satyajeetdeshmukh/Standalone-PV-Simulation/PCB_DESIGN/pcb_mega_pins.jpeg

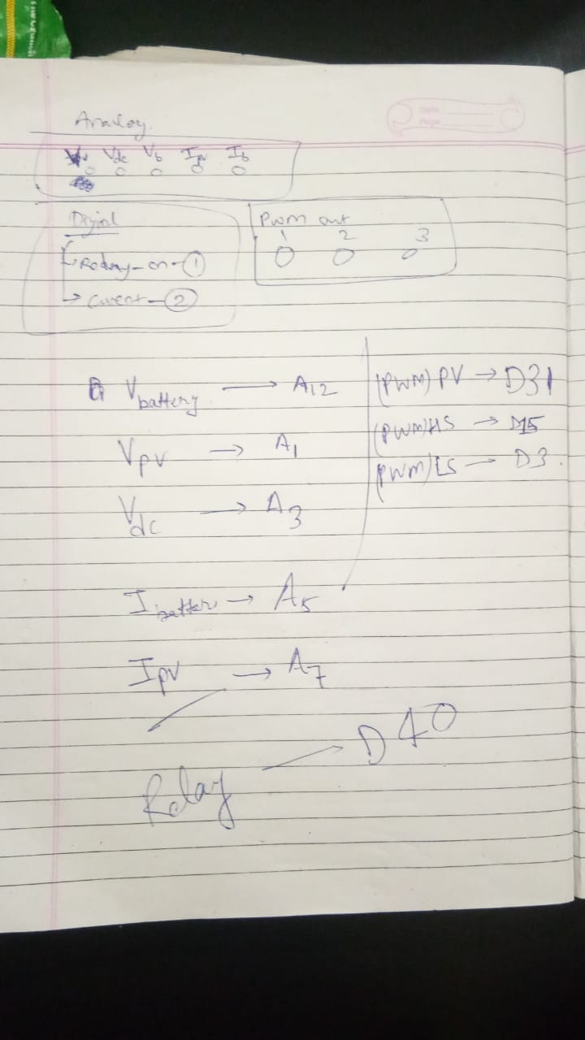
PCB_DESIGN/pcb_mega_pins.jpeg
