satyajeetdeshmukh/Standalone-PV-Simulation/Set up photos/IMG_20210410_151356.jpg

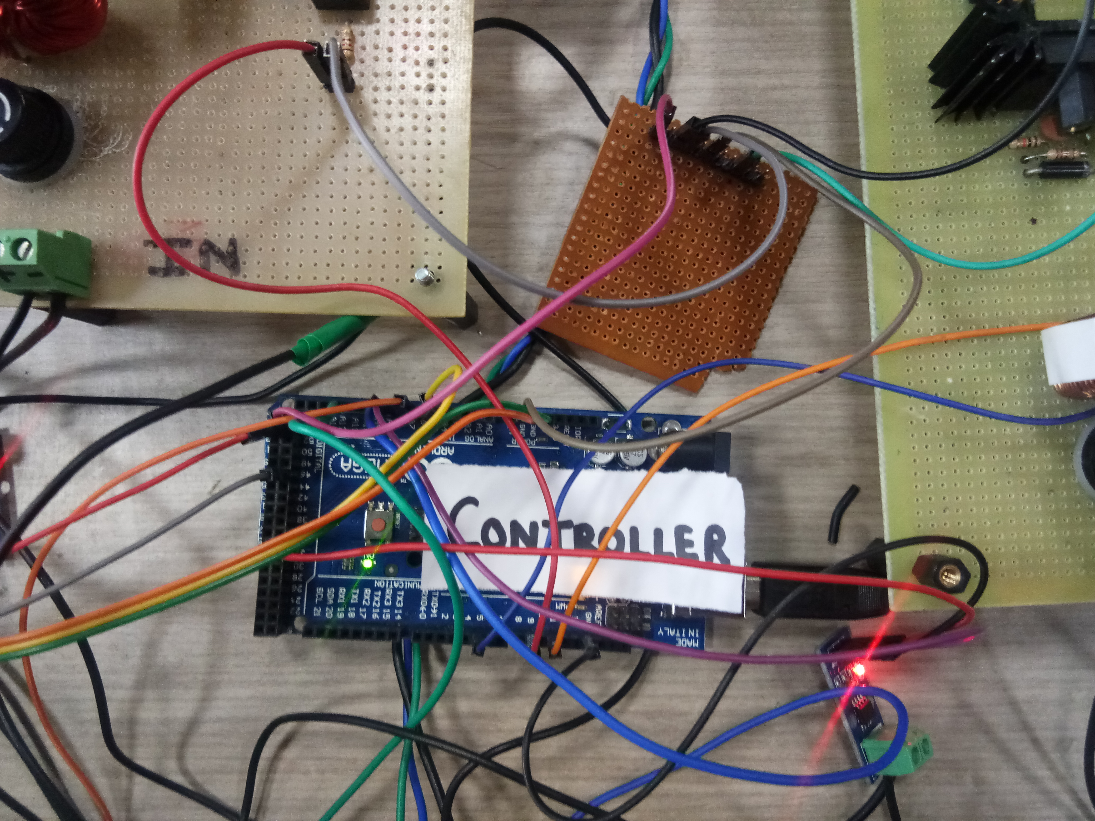
Set up photos/IMG_20210410_151356.jpg
