satyajeetdeshmukh/Standalone-PV-Simulation/Drawings/fig1 Schematic Block Diagram.pdf

PV
Subsystem

DC/DC Boost
Converter

DC/DC
Bidirectional
Converter

Load

DC - LINK

Battery
