satyajeetdeshmukh/Standalone-PV-Simulation/Drawings/fig3 Controller Design.pdf

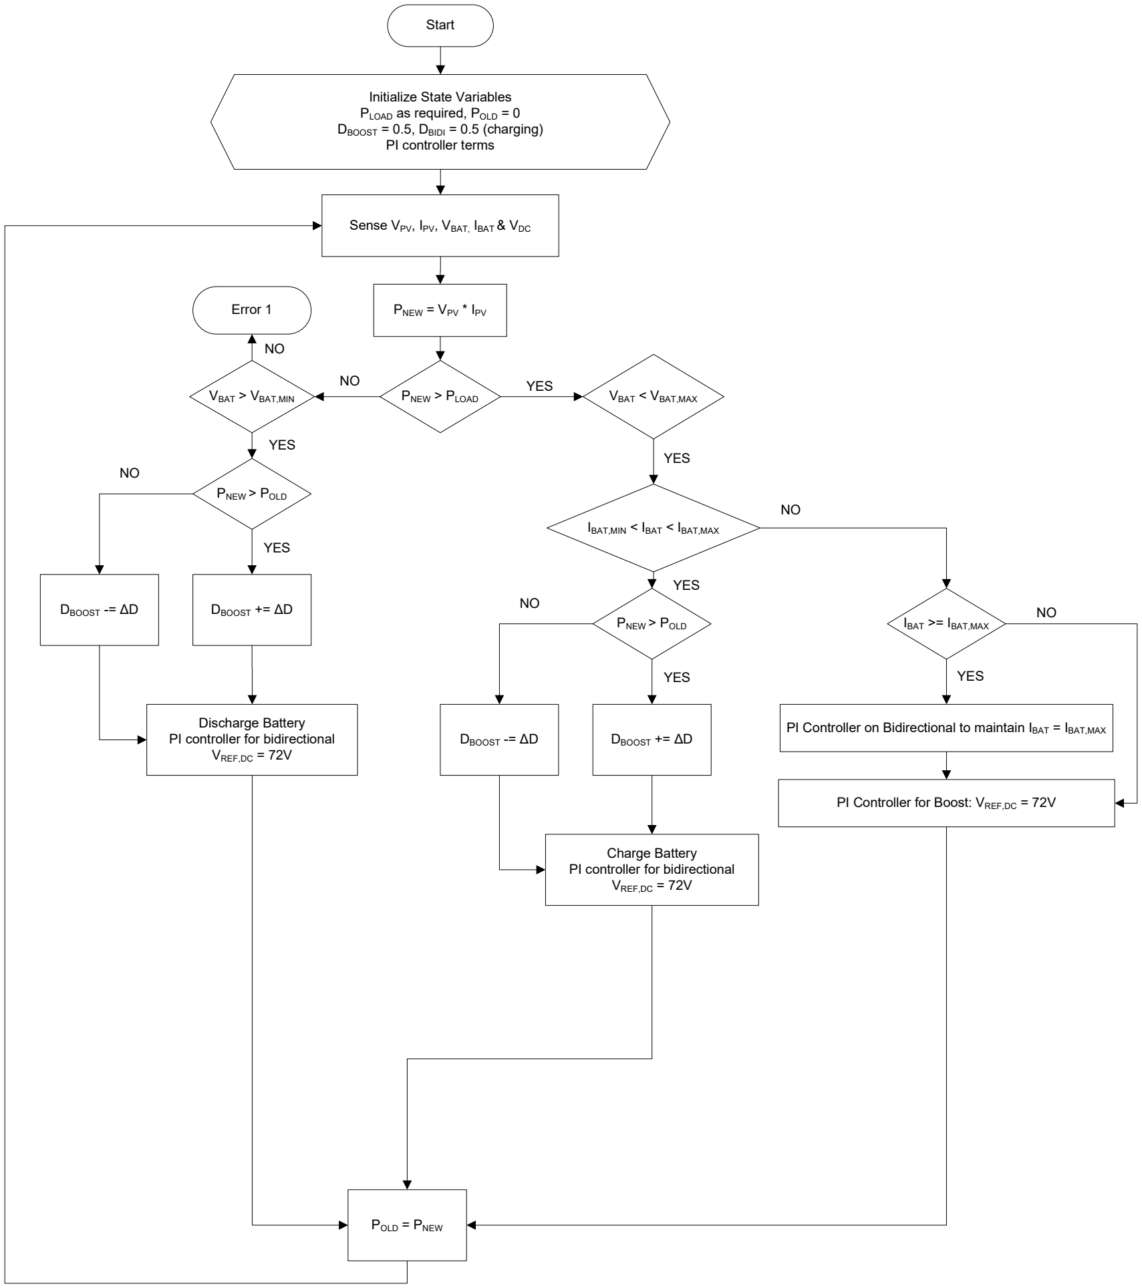
[picture p3: figure]
Sense VPV, IPV, VBAT, IBAT & VDC; Start; PNEW = VPV * IPV; VBAT > VBAT,MIN; PNEW > PLOAD; YES; PNEW > POLD; DBOOST -= ΔD; DBOOST += ΔD; Discharge Battery PI controller for bidirectional; VREF,DC = 72V; POLD = PNEW; VBAT < VBAT,MAX; IBAT,MIN < IBAT < IBAT,MAX; Charge Battery PI controller for bidirectional; Error 1; Initialize State Variables PLOAD as required, POLD = 0 DBOOST = 0.5, DBIDI = 0.5 (charging) PI controller terms; IBAT >= IBAT,MAX; PI Controller for Boost: VREF,DC = 72V

PI Controller on Bidirectional to maintain IBAT = IBAT,MAX
