satyajeetdeshmukh/Standalone-PV-Simulation/Drawings/fig 4 simple.pdf

PV
Subsystem | P.E. Converter | Load

Battery
