satyajeetdeshmukh/Standalone-PV-Simulation/Drawings/fig2 Basic Circuit Diagram.pdf

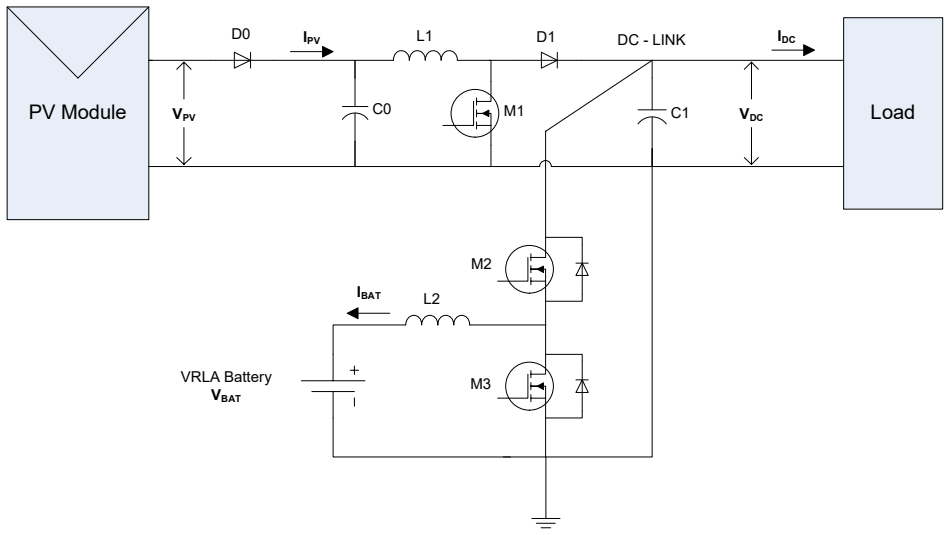
[picture p4: figure]
PV Module; Load; DC - LINK; VRLA Battery; VBAT; VDC; IBAT; IPV; IDC; VPV
