satyajeetdeshmukh/Standalone-PV-Simulation/Drawings/Control Logic - Modified.pdf

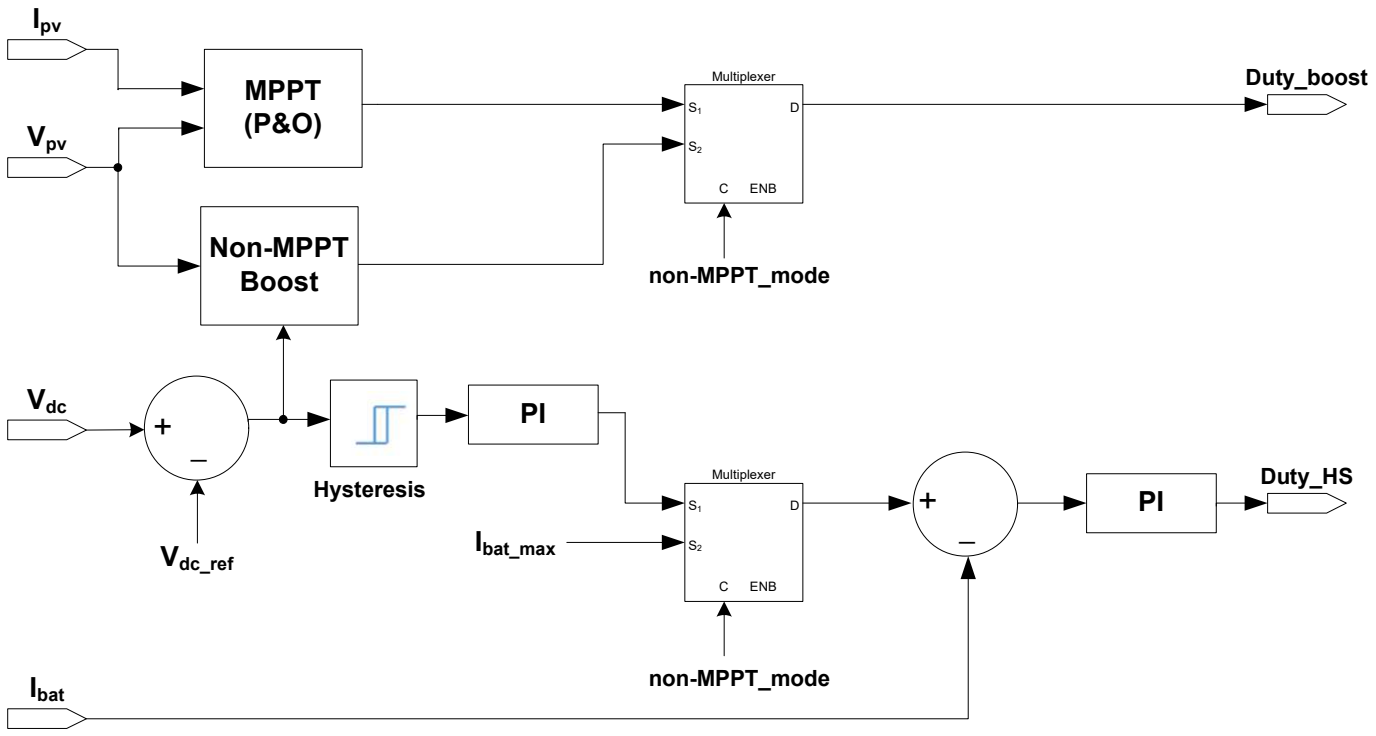
[picture p5: figure]
Ipv; Vpv; MPPT (P&O); Vdc; Vdc_ref; C ENB; Multiplexer; non-MPPT_mode; Duty_boost; Ibat_max; Ibat; Duty_HS; Hysteresis; Non-MPPT Boost
