satyajeetdeshmukh/Standalone-PV-Simulation/Drawings/DutyLS.pdf

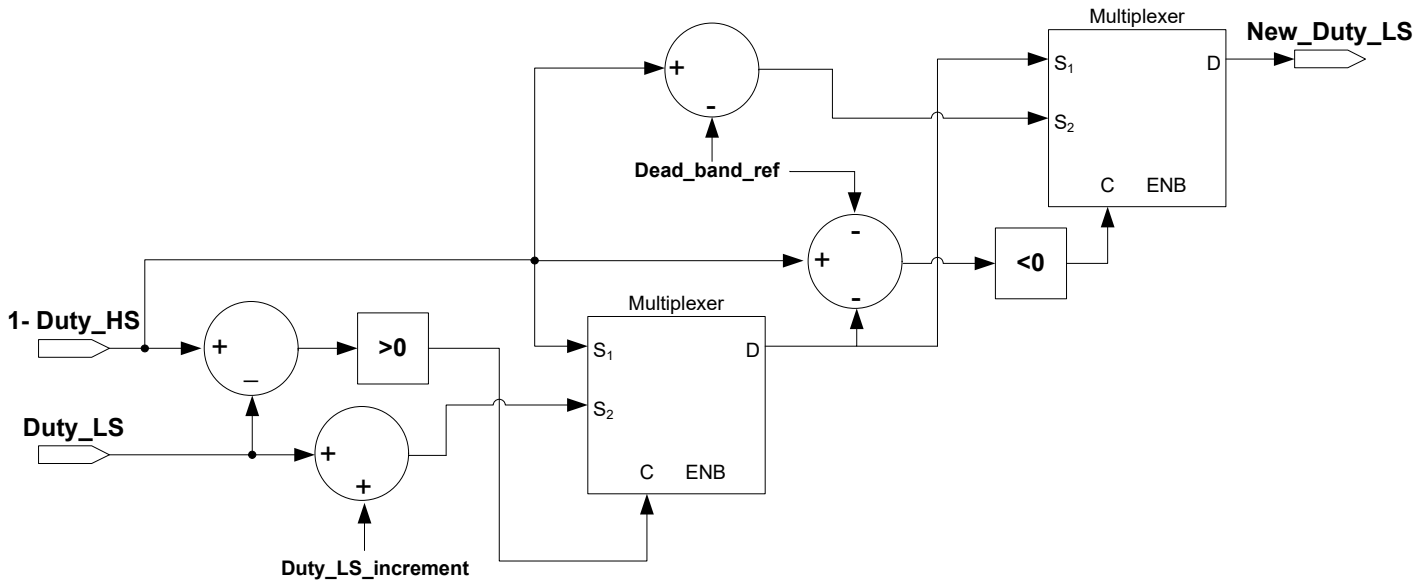
[picture p6: figure]
1- Duty_HS; Duty_LS; Duty_LS_increment; C ENB; Multiplexer; Dead_band_ref; New_Duty_LS
