satyajeetdeshmukh/Standalone-PV-Simulation/Drawings/basic_arduino_code.jpg

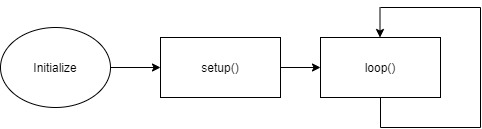
Drawings/basic_arduino_code.jpg
