satyajeetdeshmukh/Standalone-PV-Simulation/Drawings/loop_soft_start_mode.jpg

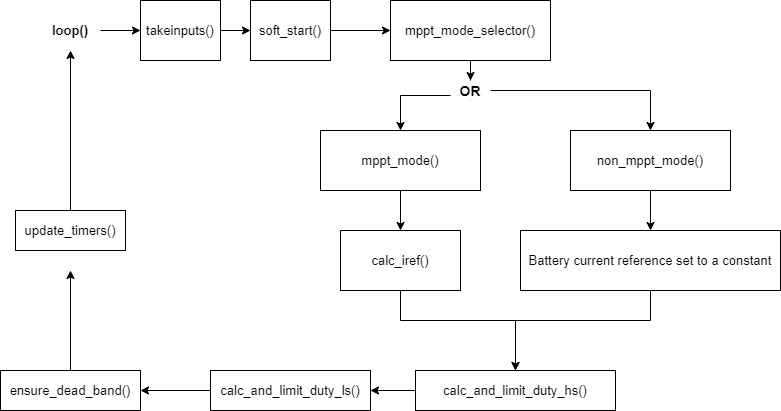
Drawings/loop_soft_start_mode.jpg
