satyajeetdeshmukh/Standalone-PV-Simulation/Set up photos/IMG_20210410_145839.jpg

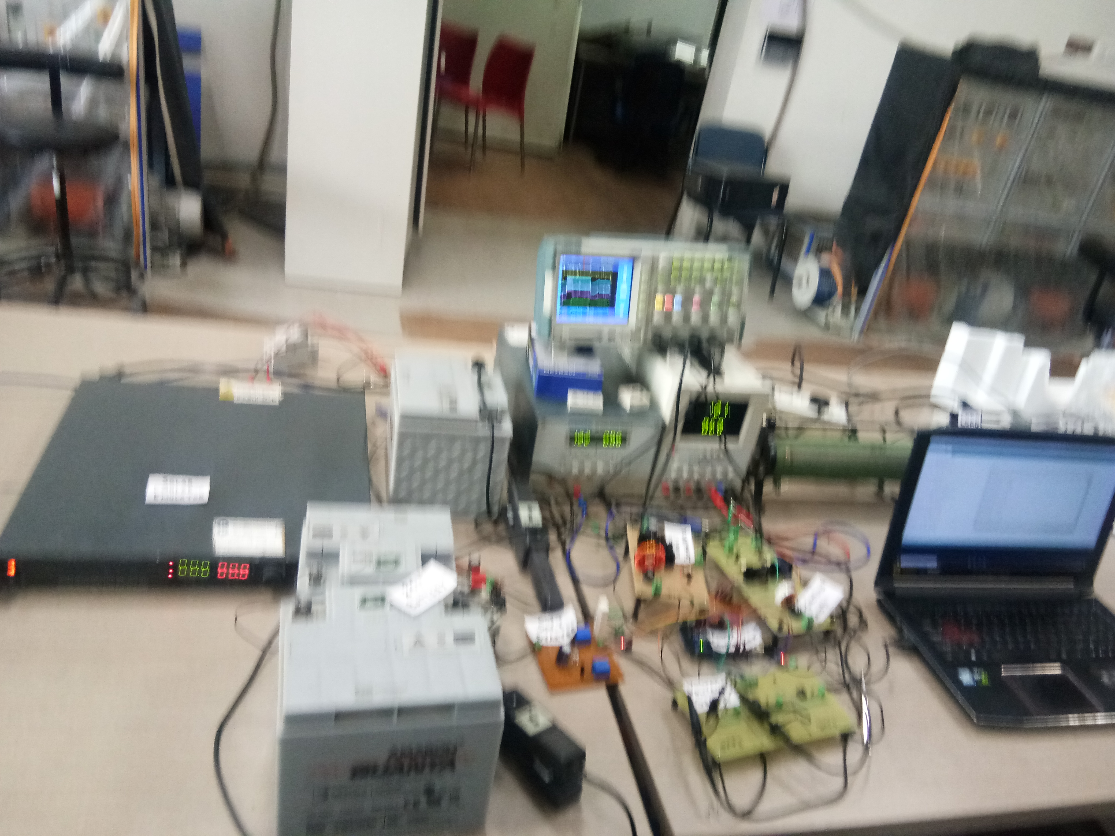
Set up photos/IMG_20210410_145839.jpg
