satyajeetdeshmukh/Standalone-PV-Simulation/Set up photos/IMG_20210410_151315.jpg

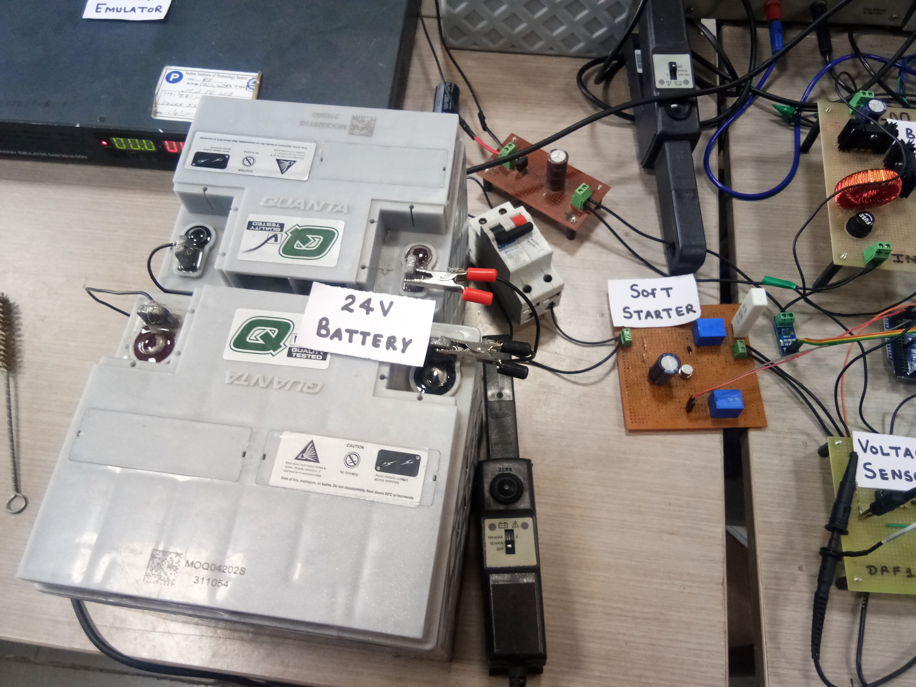
Set up photos/IMG_20210410_151315.jpg
