satyajeetdeshmukh/Standalone-PV-Simulation/Set up photos/IMG_20210411_142734.jpg

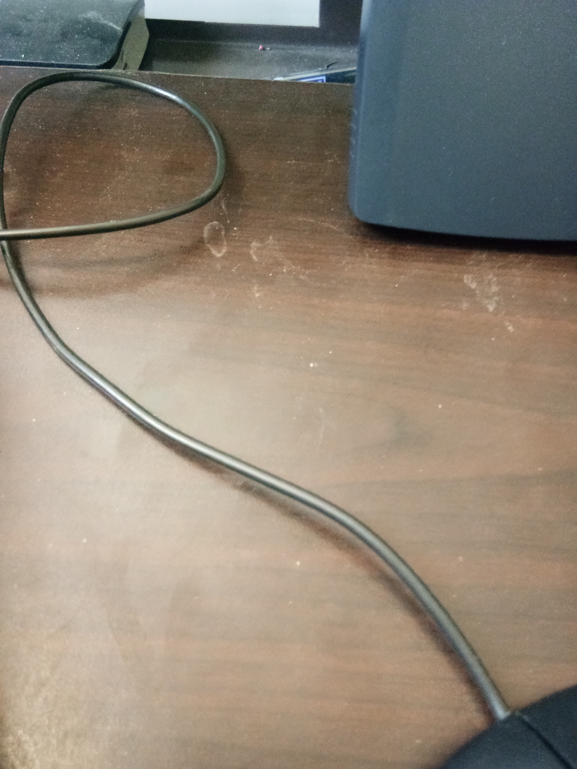
Set up photos/IMG_20210411_142734.jpg
