satyajeetdeshmukh/Standalone-PV-Simulation/Set up photos/IMG_20210412_125333.jpg

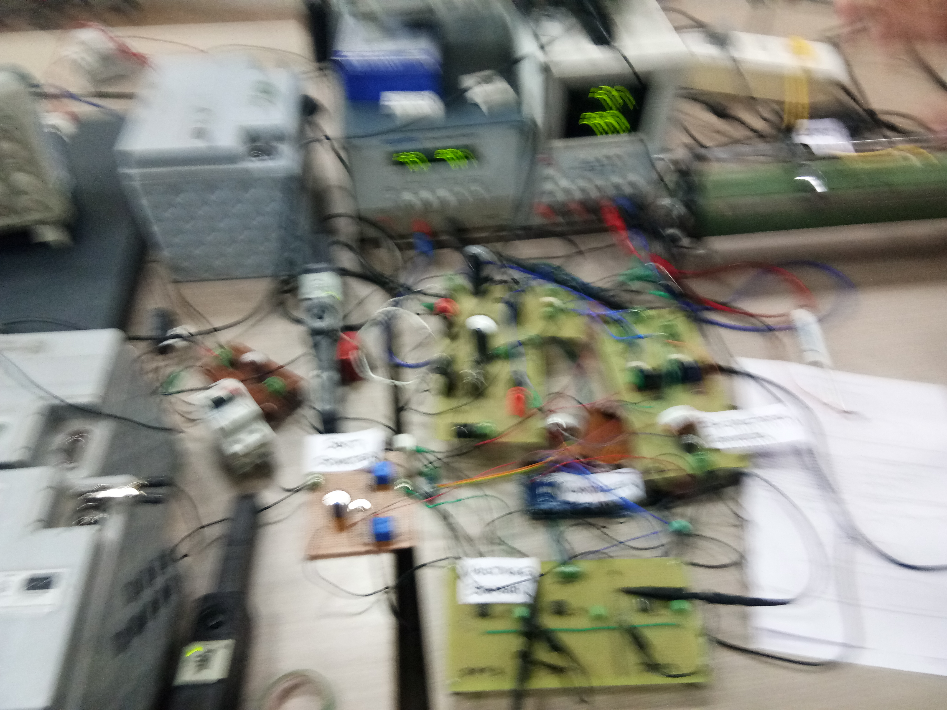
Set up photos/IMG_20210412_125333.jpg
