satyajeetdeshmukh/Standalone-PV-Simulation/Set up photos/IMG_20210412_125350.jpg

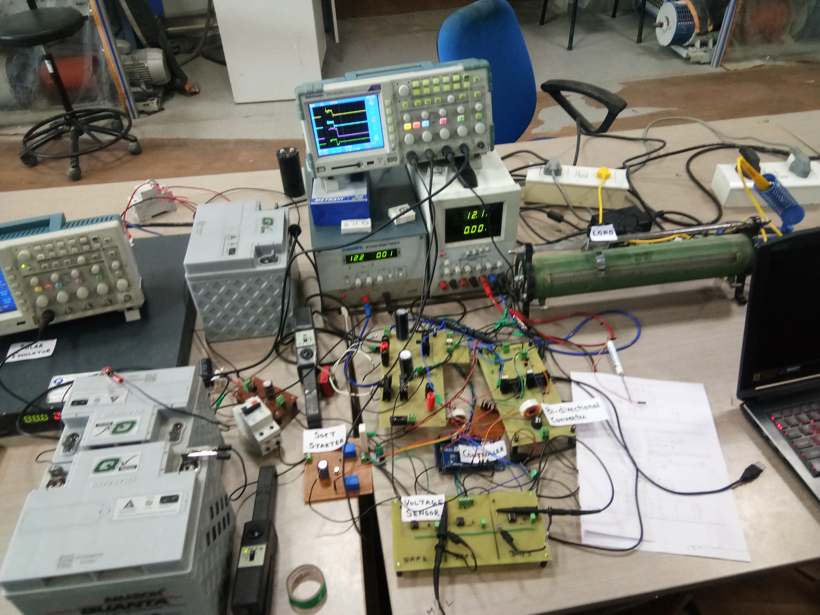
Set up photos/IMG_20210412_125350.jpg
