satyajeetdeshmukh/Standalone-PV-Simulation/Experimental_Results/Battery-only-mode/edited/full.jpg

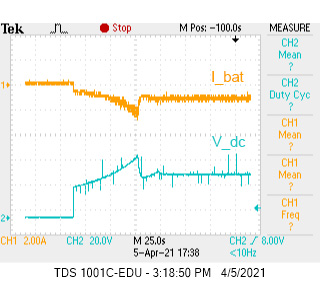
Experimental_Results/Battery-only-mode/edited/full.jpg
