satyajeetdeshmukh/Standalone-PV-Simulation/Experimental_Results/Battery-only-mode/edited/inductor current ripple stable.jpg

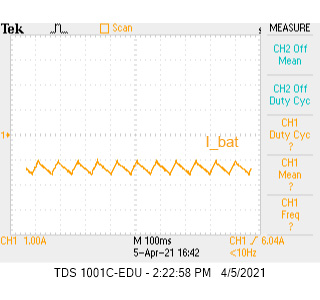
Experimental_Results/Battery-only-mode/edited/inductor current ripple stable.jpg
