satyajeetdeshmukh/Standalone-PV-Simulation/Experimental_Results/Battery-only-mode/edited/soft start.jpg

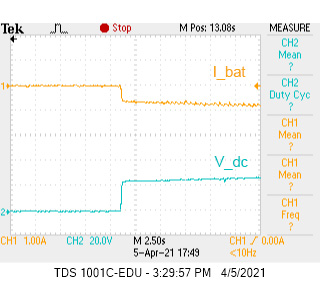
Experimental_Results/Battery-only-mode/edited/soft start.jpg
