satyajeetdeshmukh/Standalone-PV-Simulation/Experimental_Results/Battery-only-mode/steady state ch1-ib ch2-vo.bmp

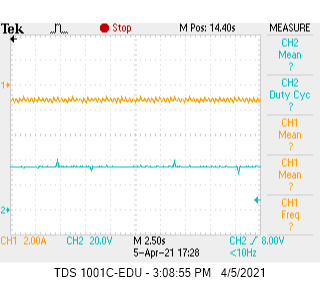
Experimental_Results/Battery-only-mode/steady state ch1-ib ch2-vo.bmp
