satyajeetdeshmukh/Standalone-PV-Simulation/Experimental_Results/battery-with-mppt/BO to BO+MPP to BO.bmp

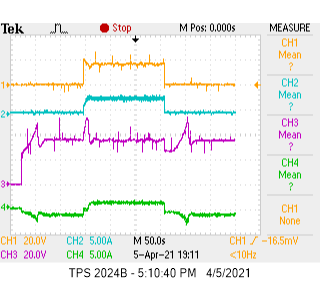
Experimental_Results/battery-with-mppt/BO to BO+MPP to BO.bmp
