satyajeetdeshmukh/Standalone-PV-Simulation/Experimental_Results/battery-with-mppt/edit/BO to BO+MPP to BO.jpg

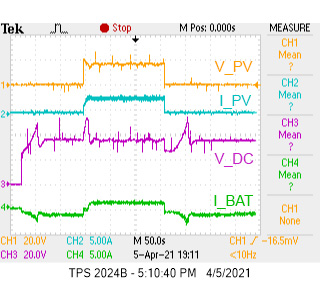
Experimental_Results/battery-with-mppt/edit/BO to BO+MPP to BO.jpg
