satyajeetdeshmukh/Standalone-PV-Simulation/Experimental_Results/battery-with-mppt/edit/mppt-with-battery-charging-to-discharging.jpg

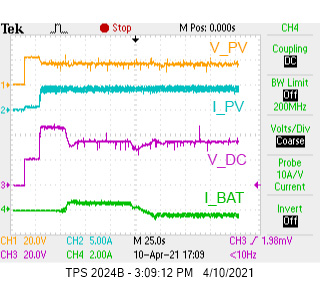
Experimental_Results/battery-with-mppt/edit/mppt-with-battery-charging-to-discharging.jpg
