satyajeetdeshmukh/Standalone-PV-Simulation/Experimental_Results/battery-with-mppt/full1.bmp

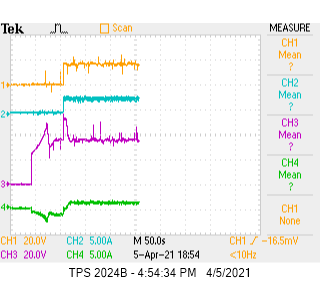
Experimental_Results/battery-with-mppt/full1.bmp
