satyajeetdeshmukh/Standalone-PV-Simulation/Experimental_Results/battery-with-mppt/mppt+battery to battery_only.bmp

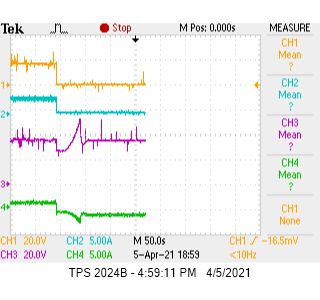
Experimental_Results/battery-with-mppt/mppt+battery to battery_only.bmp
