satyajeetdeshmukh/Standalone-PV-Simulation/Experimental_Results/battery-with-mppt/mppt_with_battery_charging-to-discharging/mppt-with-battery-charging-to-discharging.bmp

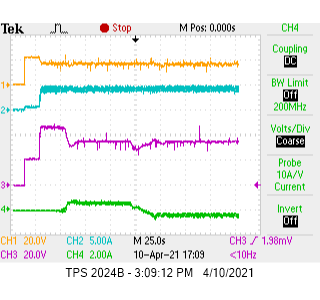
Experimental_Results/battery-with-mppt/mppt_with_battery_charging-to-discharging/mppt-with-battery-charging-to-discharging.bmp
