satyajeetdeshmukh/Standalone-PV-Simulation/Experimental_Results/mppt-to-non_mppt/2.bmp

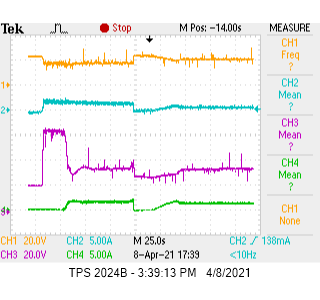
Experimental_Results/mppt-to-non_mppt/2.bmp
