satyajeetdeshmukh/Standalone-PV-Simulation/Experimental_Results/mppt-to-non_mppt/edit/mppt-to-non_mppt-to-mppt-2.jpg

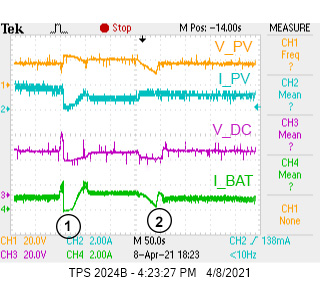
Experimental_Results/mppt-to-non_mppt/edit/mppt-to-non_mppt-to-mppt-2.jpg
