satyajeetdeshmukh/Standalone-PV-Simulation/Experimental_Results/mppt-to-non_mppt/mppt-to-non_mppt-to-mppt-2.bmp

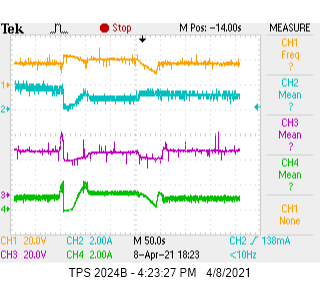
Experimental_Results/mppt-to-non_mppt/mppt-to-non_mppt-to-mppt-2.bmp
