satyajeetdeshmukh/Standalone-PV-Simulation/Experimental_Results/mppt-to-non_mppt/mppt-to-non_mppt-to-mppt.bmp

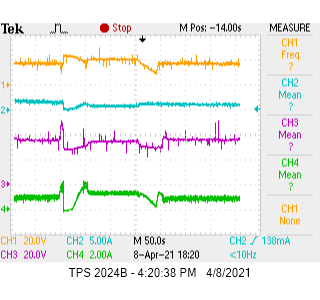
Experimental_Results/mppt-to-non_mppt/mppt-to-non_mppt-to-mppt.bmp
