satyajeetdeshmukh/Standalone-PV-Simulation/Experimental_Results/mppt-to-non_mppt/mppy_mode-to-non_mppt.bmp

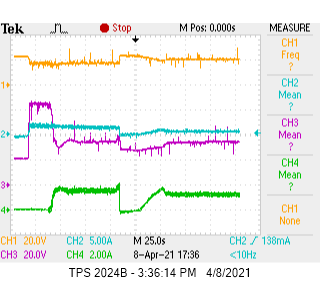
Experimental_Results/mppt-to-non_mppt/mppy_mode-to-non_mppt.bmp
