satyajeetdeshmukh/Standalone-PV-Simulation/Drawings/mode_selector.pdf

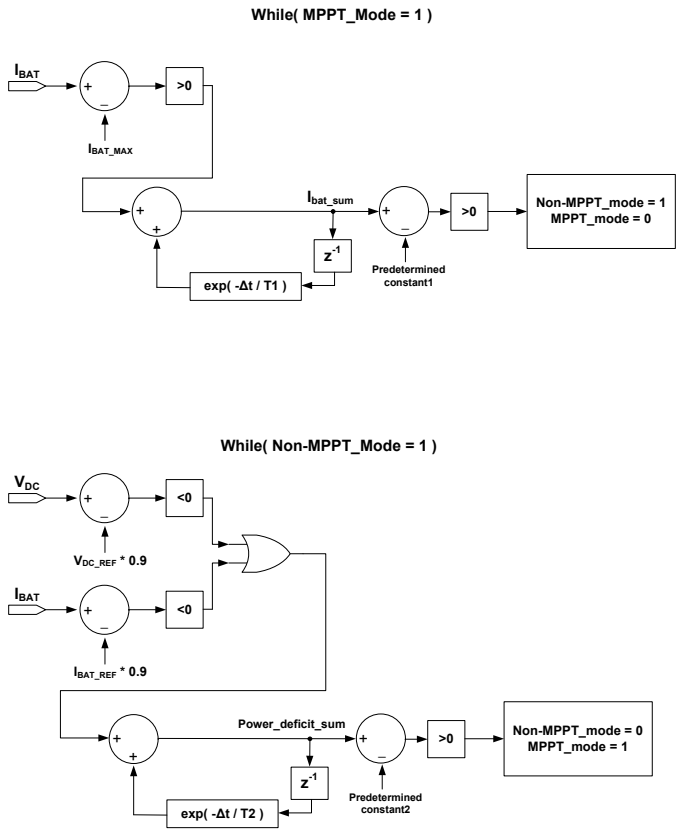
[picture p43: page 1]
Predetermined constant1; exp( -Δt / Τ1 ); Ibat_sum; Non-MPPT_mode = 1; MPPT_mode = 0; VDC; Predetermined constant2; Power_deficit_sum; Non-MPPT_mode = 0; MPPT_mode = 1; VDC_REF * 0.9; IBAT; IBAT_REF * 0.9; While( MPPT_Mode = 1 ); While( Non-MPPT_Mode = 1 ); exp( -Δt / Τ2 ); IBAT_MAX
