satyajeetdeshmukh/Standalone-PV-Simulation/PCB_DESIGN/FINAL2.PDF

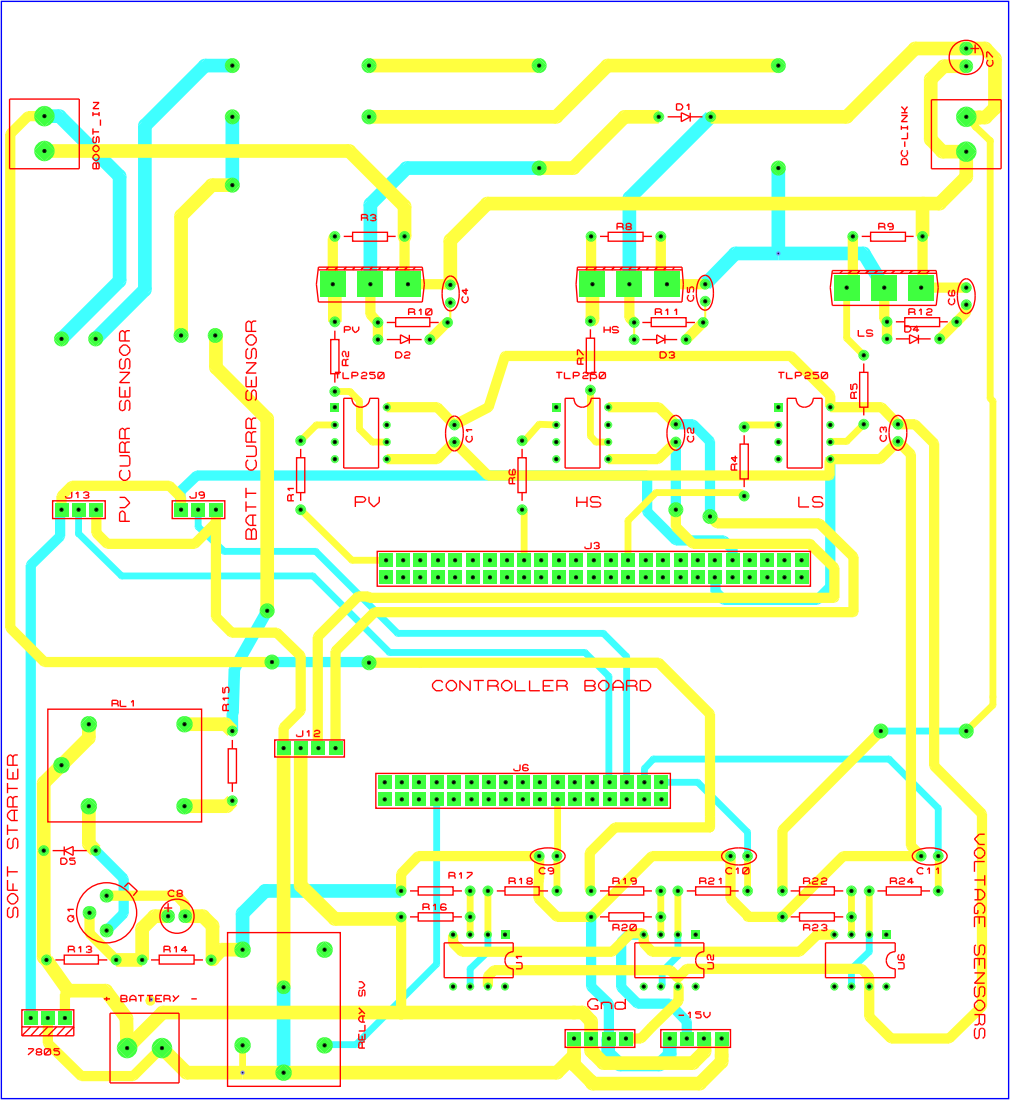
[picture p44: page 1]
