satyajeetdeshmukh/Standalone-PV-Simulation/(list of files, drawings)

Other design files:
PCB_DESIGN/FINAL2.pdsprj
PCB_DESIGN/FINAL.pdsprj
PCB_DESIGN/pcb_complete.pdsprj
PCB_DESIGN/Proteus/New Project.pdsprj
