satyajeetdeshmukh/Standalone-PV-Simulation/(commit log)

2021-02-18 more datasheets
    [BOM.xlsx]
2021-02-18 Create mosfet design considerations.pdf
2021-02-18 mosfet datasheet
2021-02-19 Design procedure for buck and boost
2021-02-20 added pdf, added proteus
    [New Project.pdsprj]
2021-03-17 bidi buck with resistor
2021-04-20 pcb and experimental setup images
    [FINAL.pdsprj, FINAL2.pdsprj, pcb_complete.pdsprj]
2021-04-20 arduino pins for pcb
    [FINAL2.pdsprj]
2021-05-31 report and file rearrangement
    [New Project.pdsprj]
